Nathan-lova/IDC_Robocon_2026_-internal-selection-competition-of-ZJU-/实物图片与比赛场地/比赛场地.jpg

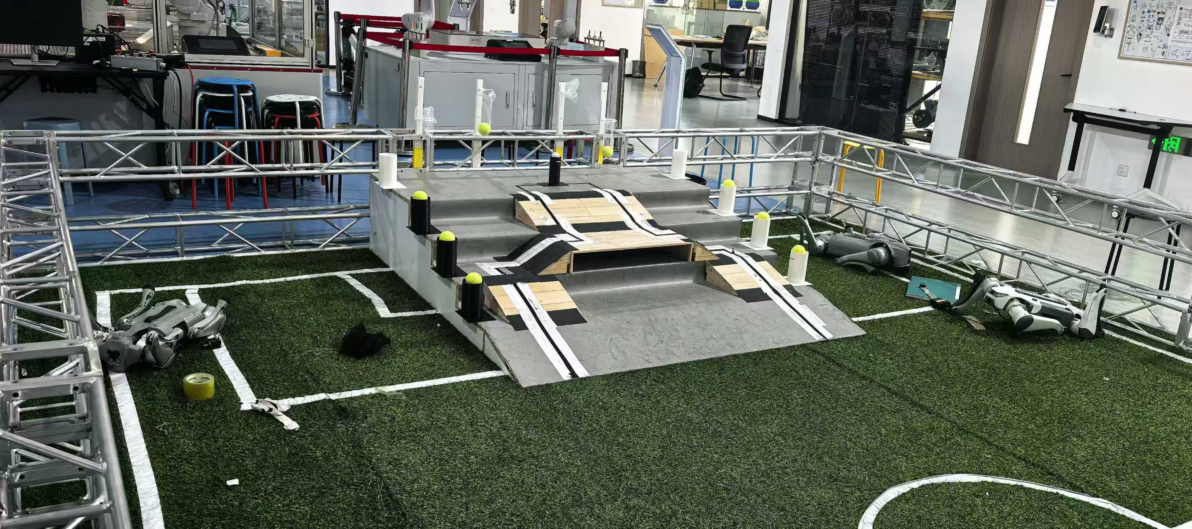
实物图片与比赛场地/比赛场地.jpg
