Nathan-lova/IDC_Robocon_2026_-internal-selection-competition-of-ZJU-/(commit log)

2026-06-01 参赛代码
2026-06-01 完善readme
